clocktop/batty_trees_test_pcb/README.md

# batty_trees_test_pcb
KiCAD project for testing the Batty Trees TSMC June 2020 Tapeout
