clocktop/batty_trees_test_pcb/batty_trees_test_pcb/batty_trees_test_pcb_bom_dk_upload.csv

Qty | Digi-Key_PN
2 | EEE-FK1K470P
20 | 490-14466-1-ND
8 | 399-9247-1-ND
40 | 399-8000-1-ND
16 | B240A-FDICT-ND
6 | 1N4148W-FDICT-ND
4 | 455-1705-ND
4 | 455-1705-ND
8 | 952-2122-ND
2 | 2223-UJC-HP-3-SMT-CT-ND
2 | J576-ND
2 | J577-ND
2 | 609-3364-ND
2
12
24 | 311-10.0KCRCT
18 | 311-100KCRCT-ND
16 | P33KDACT-ND
8
18 | 311-1.00KCRCT-ND
4 | A129743CT-ND
6
8 | 311-10.0KCRCT-ND
4 | A126379CT-ND
6 | 3266W-203LF-ND
2 | 3266W-102LF-ND
2 | CW181-ND
24 | 296-41441-1-ND
6 | LT3042EMSE#TRPBFCT-ND
2 | AD8031ARTZ-REEL7CT-ND
2 | LTC1844ES5-SD#TRMPBFCT-ND
2
