clocktop/batty_trees_test_pcb/batty_trees_test_pcb/batty_trees_test_pcb.kicad_pcb

## KiCad design batty_trees_test_pcb/batty_trees_test_pcb.kicad_pcb (2020-09-01)

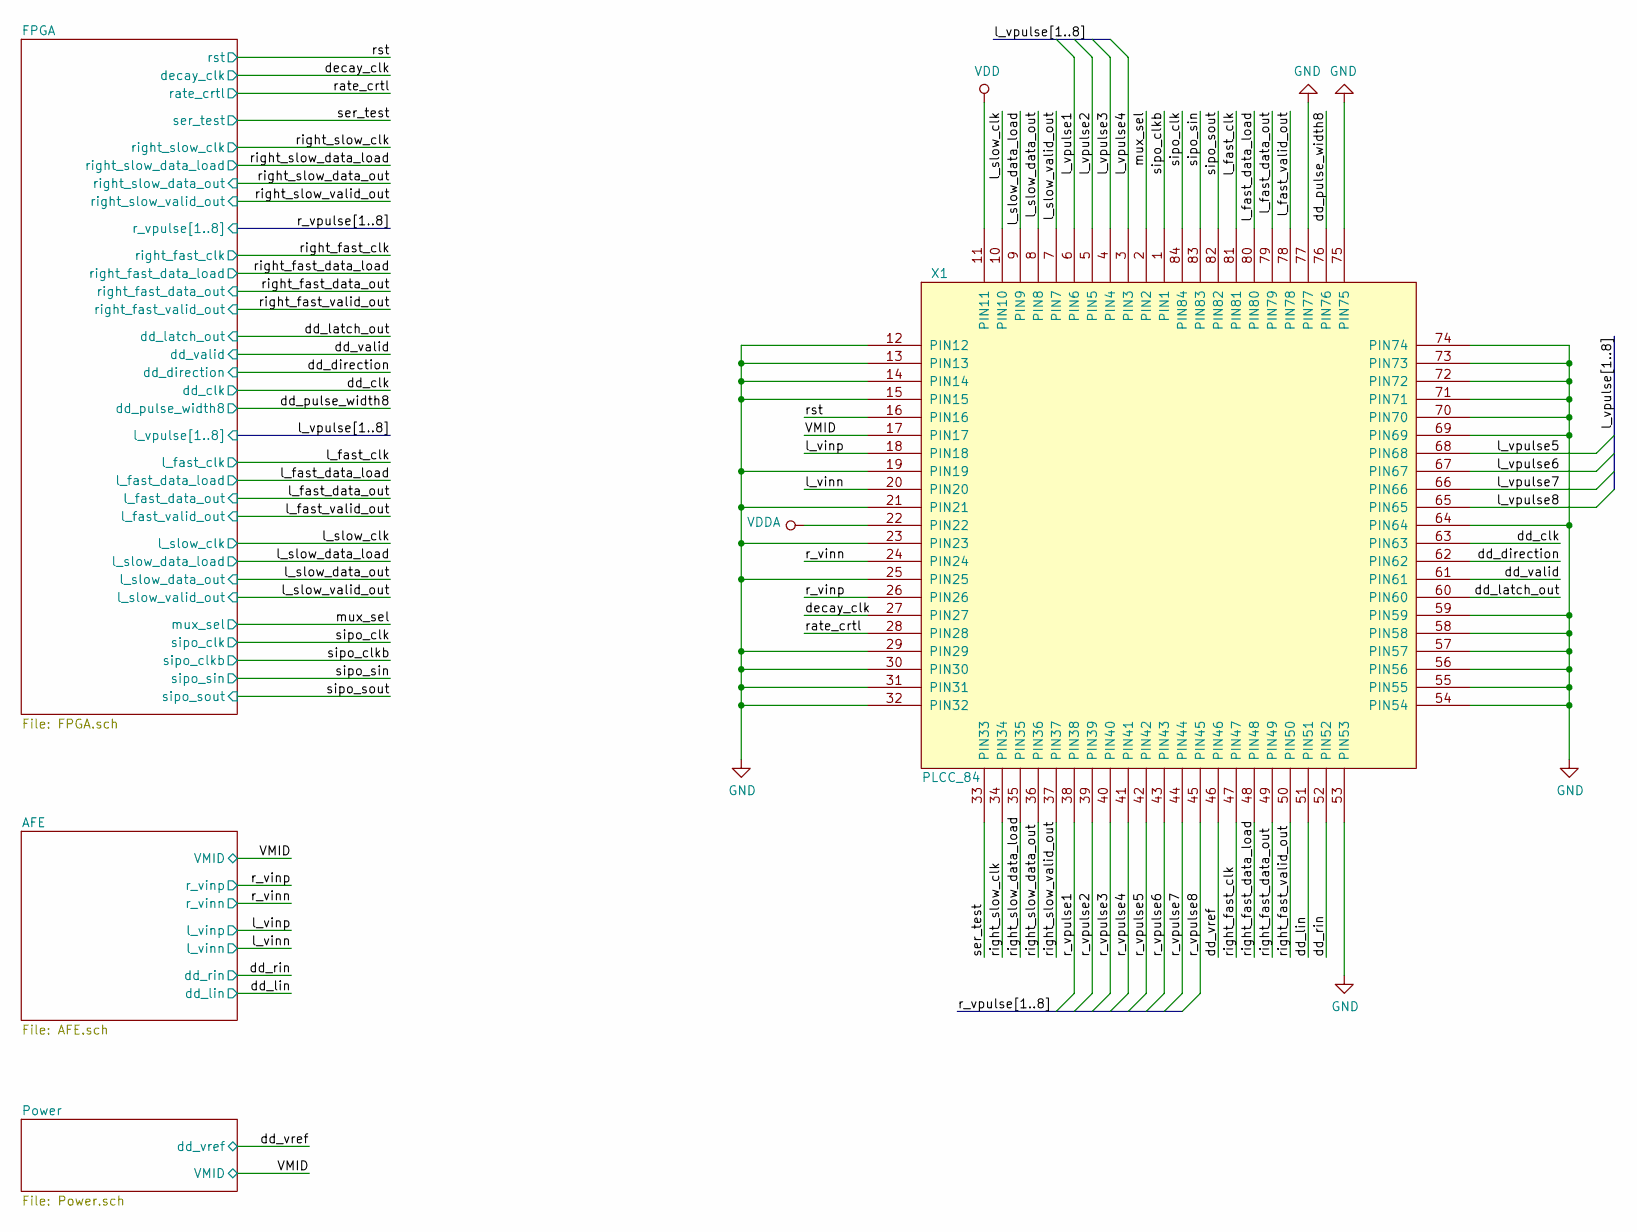
[picture p1: schematic batty_trees_test_pcb.sch, Batty Trees Test - Top]

Parts:
X1: PLCC_84; PLCC_84POS

Connections:
/VMID: X1.17 (PIN17); also elsewhere on the board
/dd_clk: X1.63 (PIN63); also elsewhere on the board
/dd_direction: X1.62 (PIN62); also elsewhere on the board
/dd_latch_out: X1.60 (PIN60); also elsewhere on the board
/dd_lin: X1.51 (PIN51); also elsewhere on the board
/dd_pulse_width8: X1.76 (PIN76); also elsewhere on the board
/dd_rin: X1.52 (PIN52); also elsewhere on the board
/dd_valid: X1.61 (PIN61); also elsewhere on the board
/dd_vref: X1.46 (PIN46); also elsewhere on the board
/decay_clk: X1.27 (PIN27); also elsewhere on the board
/l_fast_clk: X1.81 (PIN81); also elsewhere on the board
/l_fast_data_load: X1.80 (PIN80); also elsewhere on the board
/l_fast_data_out: X1.79 (PIN79); also elsewhere on the board
/l_fast_valid_out: X1.78 (PIN78); also elsewhere on the board
/l_slow_clk: X1.10 (PIN10); also elsewhere on the board
/l_slow_data_load: X1.9 (PIN9); also elsewhere on the board
/l_slow_data_out: X1.8 (PIN8); also elsewhere on the board
/l_slow_valid_out: X1.7 (PIN7); also elsewhere on the board
/l_vinn: X1.20 (PIN20); also elsewhere on the board
/l_vinp: X1.18 (PIN18); also elsewhere on the board
/l_vpulse1: X1.6 (PIN6); also elsewhere on the board
/l_vpulse2: X1.5 (PIN5); also elsewhere on the board
/l_vpulse3: X1.4 (PIN4); also elsewhere on the board
/l_vpulse4: X1.3 (PIN3); also elsewhere on the board
/l_vpulse5: X1.68 (PIN68); also elsewhere on the board
/l_vpulse6: X1.67 (PIN67); also elsewhere on the board
/l_vpulse7: X1.66 (PIN66); also elsewhere on the board
/l_vpulse8: X1.65 (PIN65); also elsewhere on the board
/mux_sel: X1.2 (PIN2); also elsewhere on the board
/r_vinn: X1.24 (PIN24); also elsewhere on the board
/r_vinp: X1.26 (PIN26); also elsewhere on the board
/r_vpulse1: X1.38 (PIN38); also elsewhere on the board
/r_vpulse2: X1.39 (PIN39); also elsewhere on the board
/r_vpulse3: X1.40 (PIN40); also elsewhere on the board
/r_vpulse4: X1.41 (PIN41); also elsewhere on the board
/r_vpulse5: X1.42 (PIN42); also elsewhere on the board
/r_vpulse6: X1.43 (PIN43); also elsewhere on the board
/r_vpulse7: X1.44 (PIN44); also elsewhere on the board
/r_vpulse8: X1.45 (PIN45); also elsewhere on the board
/rate_crtl: X1.28 (PIN28); also elsewhere on the board
/right_fast_clk: X1.47 (PIN47); also elsewhere on the board
/right_fast_data_load: X1.48 (PIN48); also elsewhere on the board
/right_fast_data_out: X1.49 (PIN49); also elsewhere on the board
/right_fast_valid_out: X1.50 (PIN50); also elsewhere on the board
/right_slow_clk: X1.34 (PIN34); also elsewhere on the board
/right_slow_data_load: X1.35 (PIN35); also elsewhere on the board
/right_slow_data_out: X1.36 (PIN36); also elsewhere on the board
/right_slow_valid_out: X1.37 (PIN37); also elsewhere on the board
/rst: X1.16 (PIN16); also elsewhere on the board
/ser_test: X1.33 (PIN33); also elsewhere on the board
/sipo_clk: X1.84 (PIN84); also elsewhere on the board
/sipo_clkb: X1.1 (PIN1); also elsewhere on the board
/sipo_sin: X1.83 (PIN83); also elsewhere on the board
/sipo_sout: X1.82 (PIN82); also elsewhere on the board
GND: X1.12 (PIN12), X1.13 (PIN13), X1.14 (PIN14), X1.15 (PIN15), X1.19 (PIN19), X1.21 (PIN21), X1.23 (PIN23), X1.25 (PIN25), X1.29 (PIN29), X1.30 (PIN30), X1.31 (PIN31), X1.32 (PIN32), X1.53 (PIN53), X1.54 (PIN54), X1.55 (PIN55), X1.56 (PIN56), X1.57 (PIN57), X1.58 (PIN58), X1.59 (PIN59), X1.64 (PIN64), X1.69 (PIN69), X1.70 (PIN70), X1.71 (PIN71), X1.72 (PIN72), X1.73 (PIN73), X1.74 (PIN74), X1.75 (PIN75), X1.77 (PIN77); also elsewhere on the board
VDD: X1.11 (PIN11); also elsewhere on the board
VDDA: X1.22 (PIN22); also elsewhere on the board

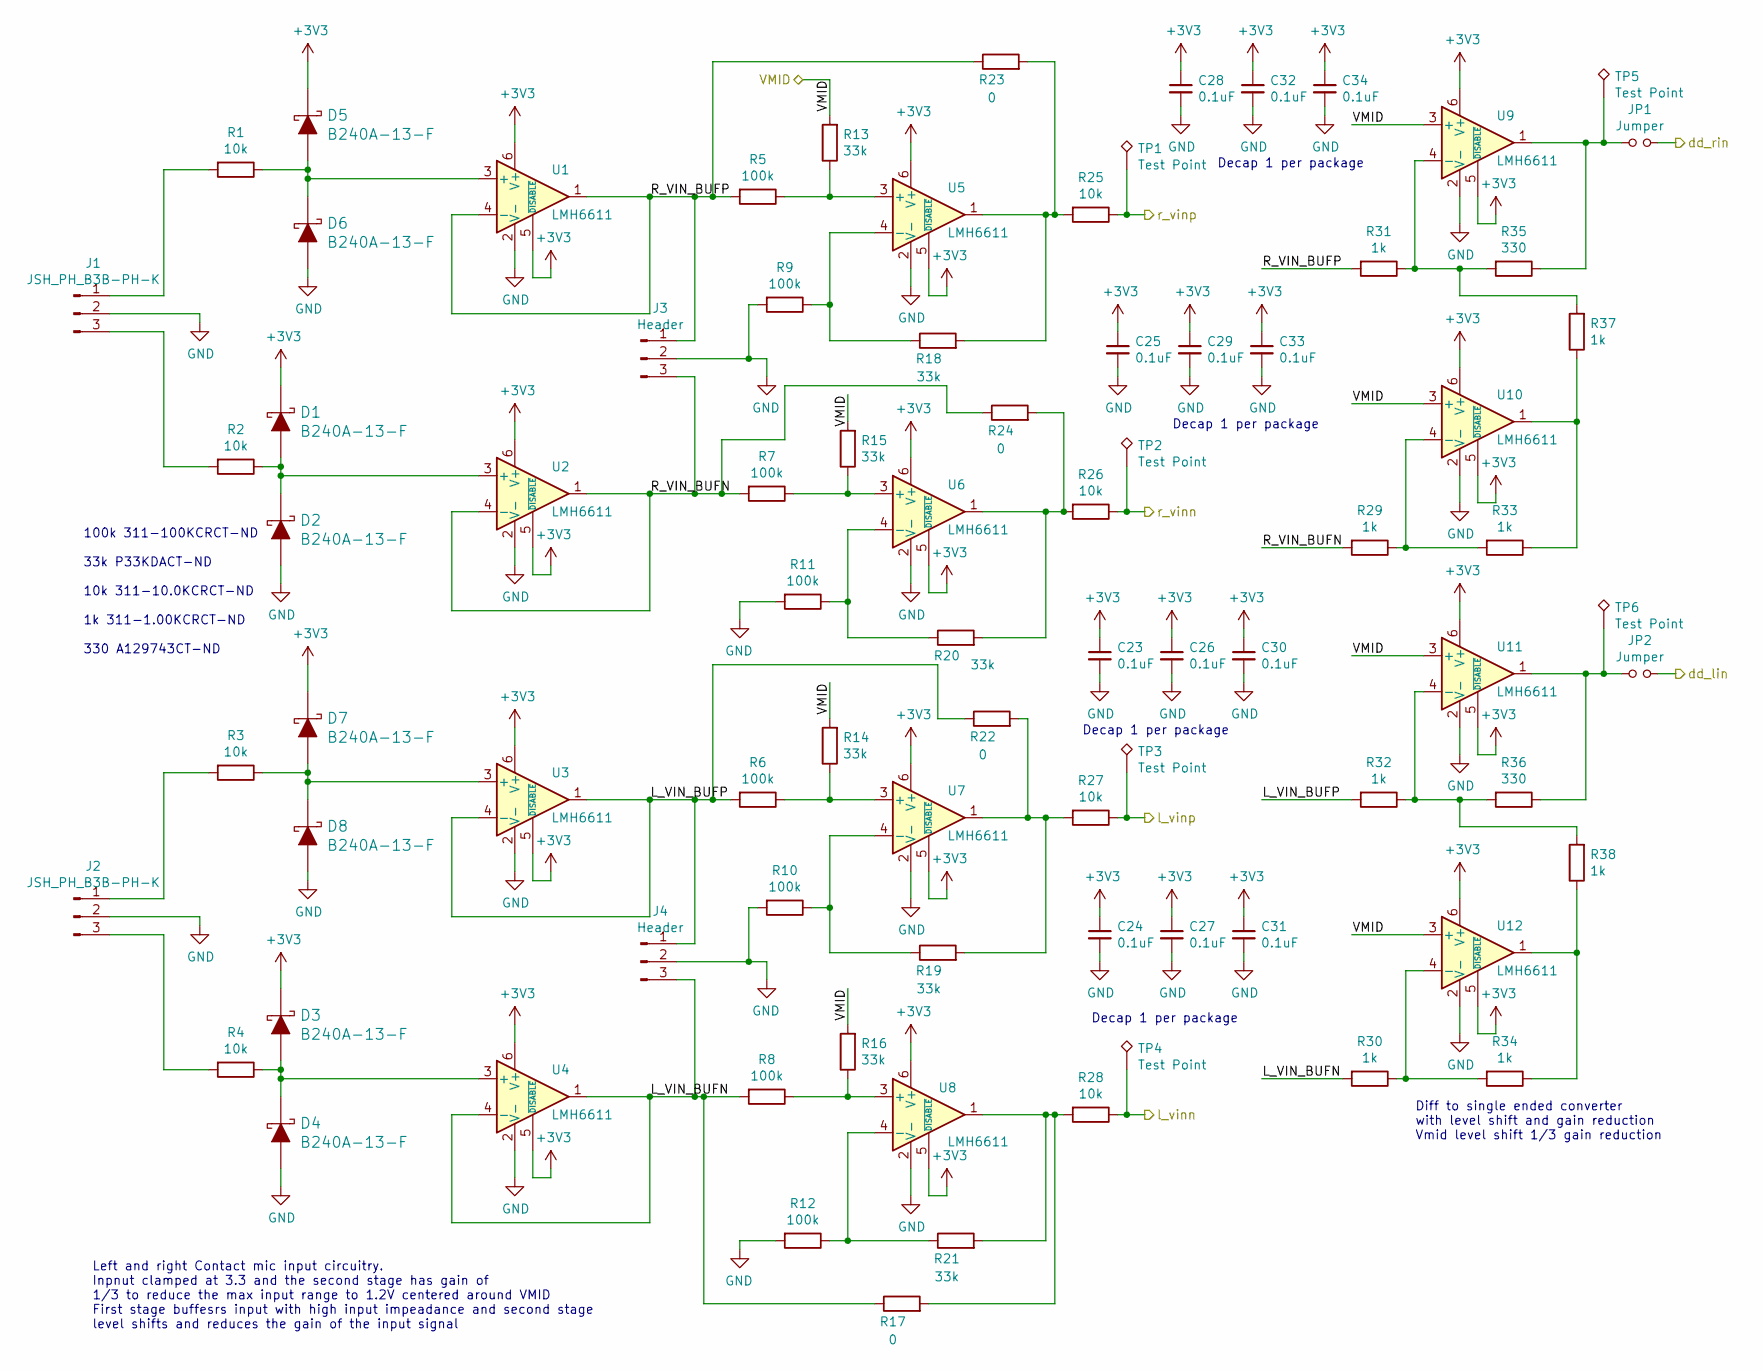
[picture p2: schematic AFE.sch]

Parts:
C23, C24, C25, C26, C27, C28, C29, C30, C31, C32, C33, C34: 0.1uF; C_0805_2012Metric_Pad1.15x1.40mm_HandSolder; Digi-Key_PN 399-8000-1-ND
D1, D2, D3, D4, D5, D6, D7, D8: B240A-13-F; DO-214AC; MPN B240A-13-F; Digi-Key_PN B240A-FDICT-ND
J1, J2: JSH_PH_B3B-PH-K; JST_PH_B3B-PH-K_1x03_P2.00mm_Vertical; Digi-Key_PN 455-1705-ND
J3, J4: Header; PinHeader_1x03_P2.54mm_Vertical; Digi-Key_PN 455-1705-ND
JP1, JP2: Jumper; PinHeader_1x02_P2.54mm_Vertical
R1, R2, R3, R4, R25, R26, R27, R28: 10k; R_0805_2012Metric_Pad1.15x1.40mm_HandSolder; Digi-Key_PN 311-10.0KCRCT
R5, R6, R7, R8, R9, R10, R11, R12: 100k; R_0805_2012Metric_Pad1.15x1.40mm_HandSolder; Digi-Key_PN 311-100KCRCT-ND
R13, R14, R15, R16, R18, R19, R20, R21: 33k; R_0805_2012Metric_Pad1.15x1.40mm_HandSolder; Digi-Key_PN P33KDACT-ND
R17, R22, R23, R24: 0; R_0805_2012Metric_Pad1.15x1.40mm_HandSolder
R29, R30, R31, R32, R33, R34, R37, R38: 1k; R_0805_2012Metric_Pad1.15x1.40mm_HandSolder; Digi-Key_PN 311-1.00KCRCT-ND
R35, R36: 330; R_0805_2012Metric_Pad1.15x1.40mm_HandSolder; Digi-Key_PN A129743CT-ND
TP1, TP2, TP3, TP4, TP5, TP6: Test Point; Keystone_5019; Digi-Key_PN 36-5019CT-ND
U1, U2, U3, U4, U5, U6, U7, U8, U9, U10, U11, U12: LMH6611; TSOT-23-6; Digi-Key_PN 296-41441-1-ND

Connections:
+3V3: C23.1, C24.1, C25.1, C26.1, C27.1, C28.1, C29.1, C30.1, C31.1, C32.1, C33.1, C34.1, D1.K, D3.K, D5.K, D7.K, U1.5 (~DISABLE), U1.6 (V+), U2.5 (~DISABLE), U2.6 (V+), U3.5 (~DISABLE), U3.6 (V+), U4.5 (~DISABLE), U4.6 (V+), U5.5 (~DISABLE), U5.6 (V+), U6.5 (~DISABLE), U6.6 (V+), U7.5 (~DISABLE), U7.6 (V+), U8.5 (~DISABLE), U8.6 (V+), U9.5 (~DISABLE), U9.6 (V+), U10.5 (~DISABLE), U10.6 (V+), U11.5 (~DISABLE), U11.6 (V+), U12.5 (~DISABLE), U12.6 (V+); also elsewhere on the board
/AFE/L_VIN_BUFN: J4.3, R8.2, R17.1, R30.2, U4.1, U4.4 (-)
/AFE/L_VIN_BUFP: J4.1, R6.2, R22.1, R32.2, U3.1, U3.4 (-)
/AFE/R_VIN_BUFN: J3.3, R7.2, R24.1, R29.2, U2.1, U2.4 (-)
/AFE/R_VIN_BUFP: J3.1, R5.2, R23.1, R31.2, U1.1, U1.4 (-)
/VMID: R13.2, R14.2, R15.2, R16.2, U9.3 (+), U10.3 (+), U11.3 (+), U12.3 (+); also elsewhere on the board
/dd_lin: JP2.2; also elsewhere on the board
/dd_rin: JP1.2; also elsewhere on the board
/l_vinn: R28.1, TP4.1; also elsewhere on the board
/l_vinp: R27.1, TP3.1; also elsewhere on the board
/r_vinn: R26.1, TP2.1; also elsewhere on the board
/r_vinp: R25.1, TP1.1; also elsewhere on the board
GND: C23.2, C24.2, C25.2, C26.2, C27.2, C28.2, C29.2, C30.2, C31.2, C32.2, C33.2, C34.2, D2.A, D4.A, D6.A, D8.A, J1.2, J2.2, J3.2, J4.2, R9.2, R10.2, R11.2, R12.2, U1.2 (V-), U2.2 (V-), U3.2 (V-), U4.2 (V-), U5.2 (V-), U6.2 (V-), U7.2 (V-), U8.2 (V-), U9.2 (V-), U10.2 (V-), U11.2 (V-), U12.2 (V-); also elsewhere on the board
unnamed: D1.A, D2.K, R2.1, U2.3 (+)
unnamed: D3.A, D4.K, R4.1, U4.3 (+)
unnamed: D5.A, D6.K, R1.1, U1.3 (+)
unnamed: D7.A, D8.K, R3.1, U3.3 (+)
unnamed: J1.1, R1.2
unnamed: J1.3, R2.2
unnamed: J2.1, R3.2
unnamed: J2.3, R4.2
unnamed: JP1.1, R35.1, TP5.1, U9.1
unnamed: JP2.1, R36.1, TP6.1, U11.1
unnamed: R10.1, R19.1, U7.4 (-)
unnamed: R11.1, R20.1, U6.4 (-)
unnamed: R12.1, R21.1, U8.4 (-)
unnamed: R5.1, R13.1, U5.3 (+)
unnamed: R6.1, R14.1, U7.3 (+)
unnamed: R7.1, R15.1, U6.3 (+)
unnamed: R8.1, R16.1, U8.3 (+)
unnamed: R17.2, R21.2, R28.2, U8.1
unnamed: R9.1, R18.1, U5.4 (-)
unnamed: R18.2, R23.2, R25.2, U5.1
unnamed: R19.2, R22.2, R27.2, U7.1
unnamed: R20.2, R24.2, R26.2, U6.1
unnamed: R29.1, R33.2, U10.4 (-)
unnamed: R30.1, R34.2, U12.4 (-)
unnamed: R31.1, R35.2, R37.2, U9.4 (-)
unnamed: R32.1, R36.2, R38.2, U11.4 (-)
unnamed: R33.1, R37.1, U10.1
unnamed: R34.1, R38.1, U12.1

Notes on the sheet:
Left and right Contact mic input circuitry. Inpnut clamped at 3.3 and the second stage has gain of 1/3 to reduce the max input range to 1.2V centered around VMID First stage buffesrs input with high input impeadance and second stage level shifts and reduces the gain of the input signal
Diff to single ended converter with level shift and gain reduction Vmid level shift 1/3 gain reduction
Decap 1 per package
100k 311-100KCRCT-ND 33k P33KDACT-ND 10k 311-10.0KCRCT-ND 1k 311-1.00KCRCT-ND 330 A129743CT-ND

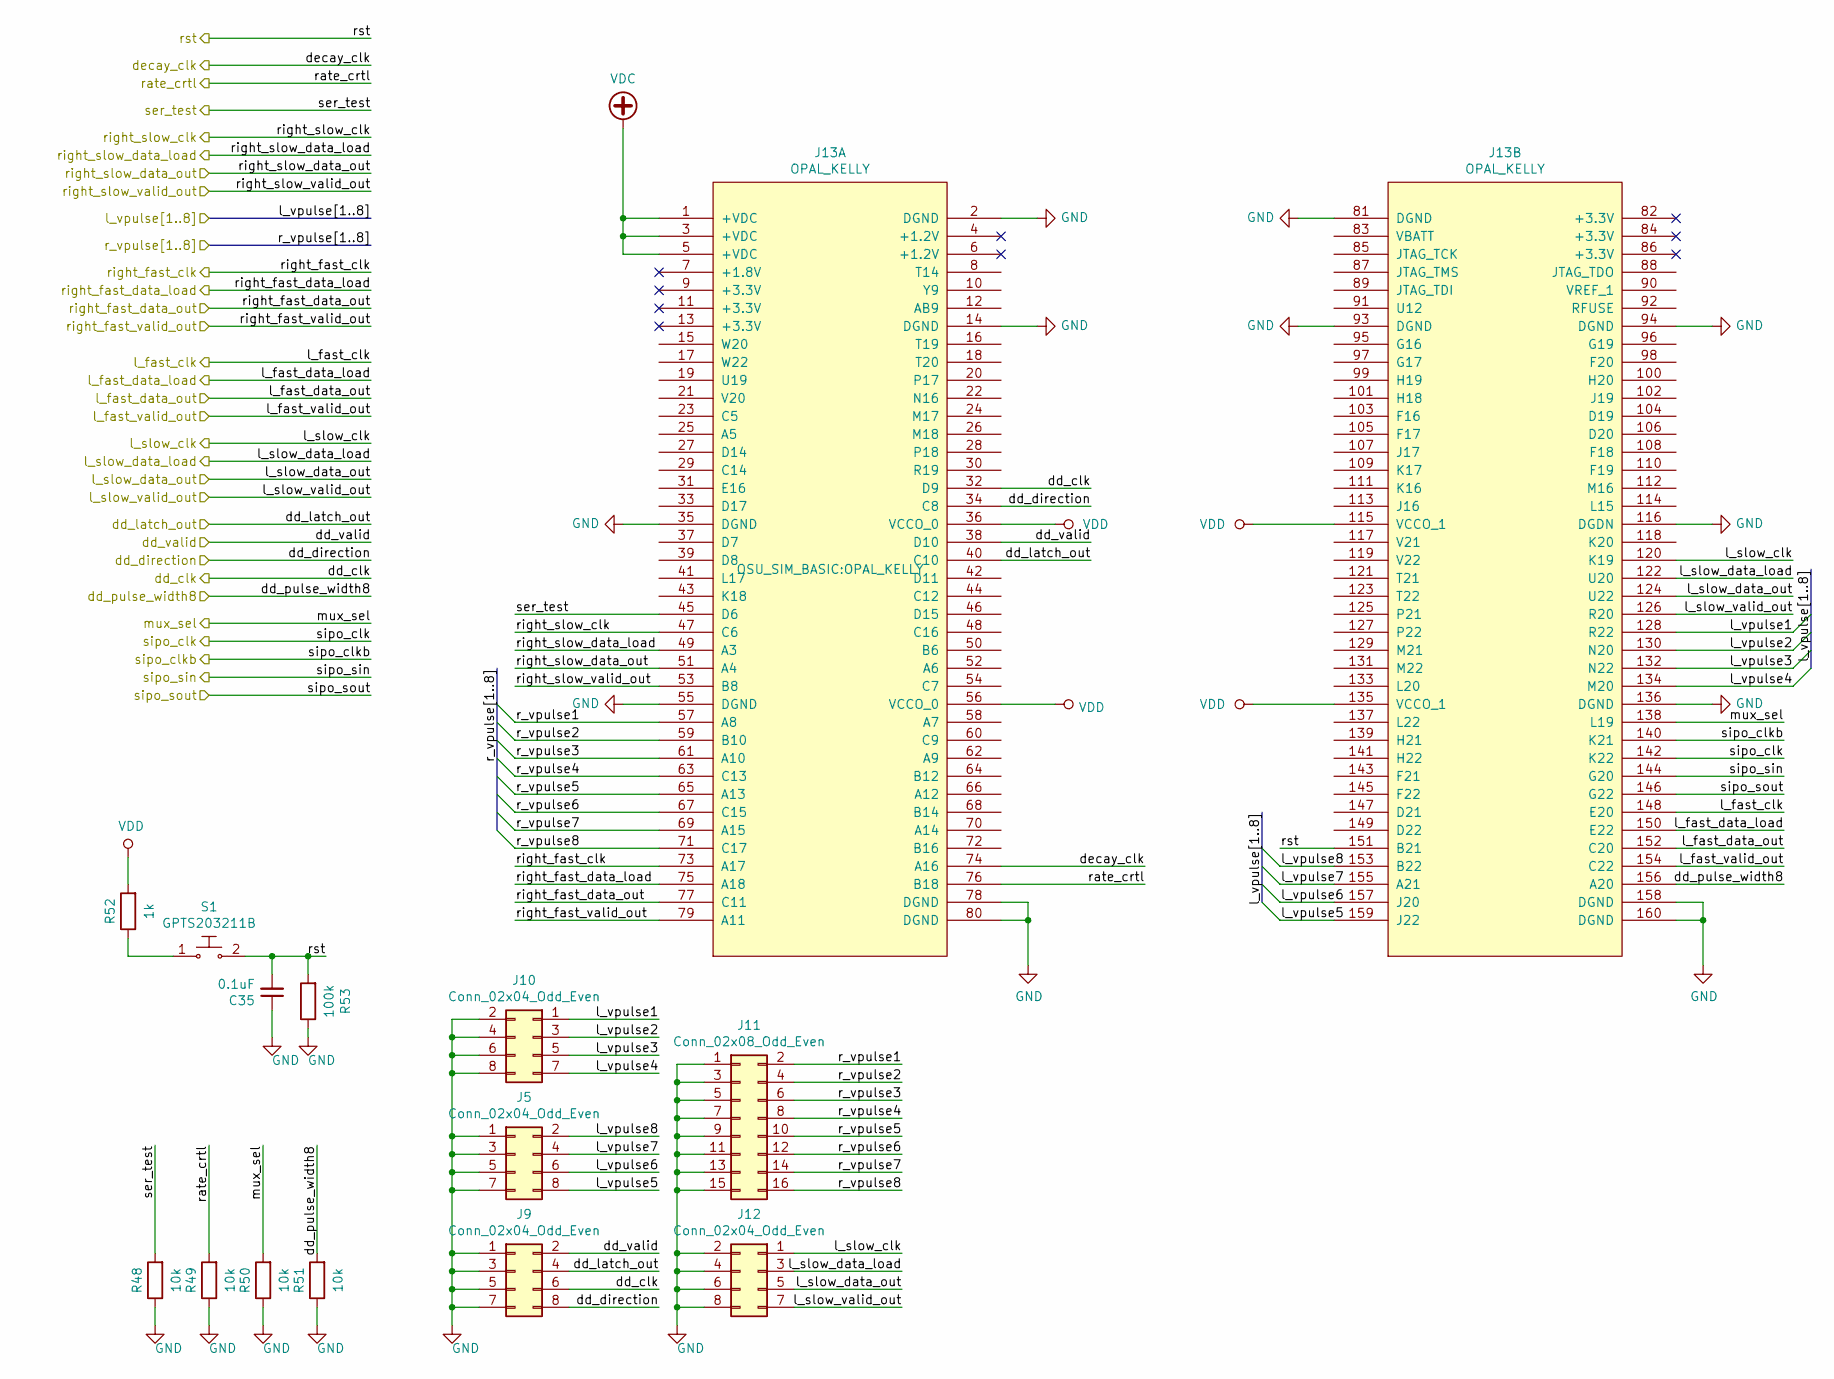
[picture p3: schematic FPGA.sch, Batty Trees - FPGA]

Parts:
C35: 0.1uF; C_0805_2012Metric_Pad1.15x1.40mm_HandSolder; Digi-Key_PN 399-8000-1-ND
J5, J9, J10, J12: Conn_02x04_Odd_Even; PinHeader_2x04_P2.54mm_Vertical; Digi-Key_PN 952-2122-ND
J11: Conn_02x08_Odd_Even; PinHeader_2x08_P2.54mm_Vertical; Digi-Key_PN 609-3364-ND
J13: OPAL_KELLY
R48, R49, R51: 10k; R_0805_2012Metric_Pad1.15x1.40mm_HandSolder; Digi-Key_PN 311-10.0KCRCT-ND
R50: 10k; R_0805_2012Metric_Pad1.15x1.40mm_HandSolder; Digi-Key-PN 311-10.0KCRCT-ND
R52: 1k; R_0805_2012Metric_Pad1.15x1.40mm_HandSolder; Digi-Key-PN 311-1.00KCRCT-ND
R53: 100k; R_0805_2012Metric_Pad1.15x1.40mm_HandSolder; Digi-Key_PN 311-100KCRCT-ND
S1: GPTS203211B; PushButton_12x12mm_THT_GPTS203211B; MPN GPTS203211B; Digi-Key_PN CW181-ND

Connections:
/dd_clk: J9.6, J13.32 (D9); also elsewhere on the board
/dd_direction: J9.8, J13.34 (C8); also elsewhere on the board
/dd_latch_out: J9.4, J13.40 (C10); also elsewhere on the board
/dd_pulse_width8: J13.156 (A20), R51.2; also elsewhere on the board
/dd_valid: J9.2, J13.38 (D10); also elsewhere on the board
/decay_clk: J13.74 (A16); also elsewhere on the board
/l_fast_clk: J13.148 (E20); also elsewhere on the board
/l_fast_data_load: J13.150 (E22); also elsewhere on the board
/l_fast_data_out: J13.152 (C20); also elsewhere on the board
/l_fast_valid_out: J13.154 (C22); also elsewhere on the board
/l_slow_clk: J12.1, J13.120 (K19); also elsewhere on the board
/l_slow_data_load: J12.3, J13.122 (U20); also elsewhere on the board
/l_slow_data_out: J12.5, J13.124 (U22); also elsewhere on the board
/l_slow_valid_out: J12.7, J13.126 (R20); also elsewhere on the board
/l_vpulse1: J10.1, J13.128 (R22); also elsewhere on the board
/l_vpulse2: J10.3, J13.130 (N20); also elsewhere on the board
/l_vpulse3: J10.5, J13.132 (N22); also elsewhere on the board
/l_vpulse4: J10.7, J13.134 (M20); also elsewhere on the board
/l_vpulse5: J5.8, J13.159 (J22); also elsewhere on the board
/l_vpulse6: J5.6, J13.157 (J20); also elsewhere on the board
/l_vpulse7: J5.4, J13.155 (A21); also elsewhere on the board
/l_vpulse8: J5.2, J13.153 (B22); also elsewhere on the board
/mux_sel: J13.138 (L19), R50.2; also elsewhere on the board
/r_vpulse1: J11.2, J13.57 (A8); also elsewhere on the board
/r_vpulse2: J11.4, J13.59 (B10); also elsewhere on the board
/r_vpulse3: J11.6, J13.61 (A10); also elsewhere on the board
/r_vpulse4: J11.8, J13.63 (C13); also elsewhere on the board
/r_vpulse5: J11.10, J13.65 (A13); also elsewhere on the board
/r_vpulse6: J11.12, J13.67 (C15); also elsewhere on the board
/r_vpulse7: J11.14, J13.69 (A15); also elsewhere on the board
/r_vpulse8: J11.16, J13.71 (C17); also elsewhere on the board
/rate_crtl: J13.76 (B18), R49.2; also elsewhere on the board
/right_fast_clk: J13.73 (A17); also elsewhere on the board
/right_fast_data_load: J13.75 (A18); also elsewhere on the board
/right_fast_data_out: J13.77 (C11); also elsewhere on the board
/right_fast_valid_out: J13.79 (A11); also elsewhere on the board
/right_slow_clk: J13.47 (C6); also elsewhere on the board
/right_slow_data_load: J13.49 (A3); also elsewhere on the board
/right_slow_data_out: J13.51 (A4); also elsewhere on the board
/right_slow_valid_out: J13.53 (B8); also elsewhere on the board
/rst: C35.2, J13.151 (B21), R53.2, S1.2; also elsewhere on the board
/ser_test: J13.45 (D6), R48.2; also elsewhere on the board
/sipo_clk: J13.142 (K22); also elsewhere on the board
/sipo_clkb: J13.140 (K21); also elsewhere on the board
/sipo_sin: J13.144 (G20); also elsewhere on the board
/sipo_sout: J13.146 (G22); also elsewhere on the board
GND: C35.1, J5.1, J5.3, J5.5, J5.7, J9.1, J9.3, J9.5, J9.7, J10.2, J10.4, J10.6, J10.8, J11.1, J11.3, J11.5, J11.7, J11.9, J11.11, J11.13, J11.15, J12.2, J12.4, J12.6, J12.8, J13.2 (DGND), J13.14 (DGND), J13.35 (DGND), J13.55 (DGND), J13.78 (DGND), J13.80 (DGND), J13.81 (DGND), J13.93 (DGND), J13.94 (DGND), J13.116 (DGDN), J13.136 (DGND), J13.158 (DGND), J13.160 (DGND), R48.1, R49.1, R50.1, R51.1, R53.1; also elsewhere on the board
unnamed: R52.1, S1.1
VDC: J13.1 (+VDC), J13.3 (+VDC), J13.5 (+VDC); also elsewhere on the board
VDD: J13.36 (VCCO_0), J13.56 (VCCO_0), J13.115 (VCCO_1), J13.135 (VCCO_1), R52.2; also elsewhere on the board

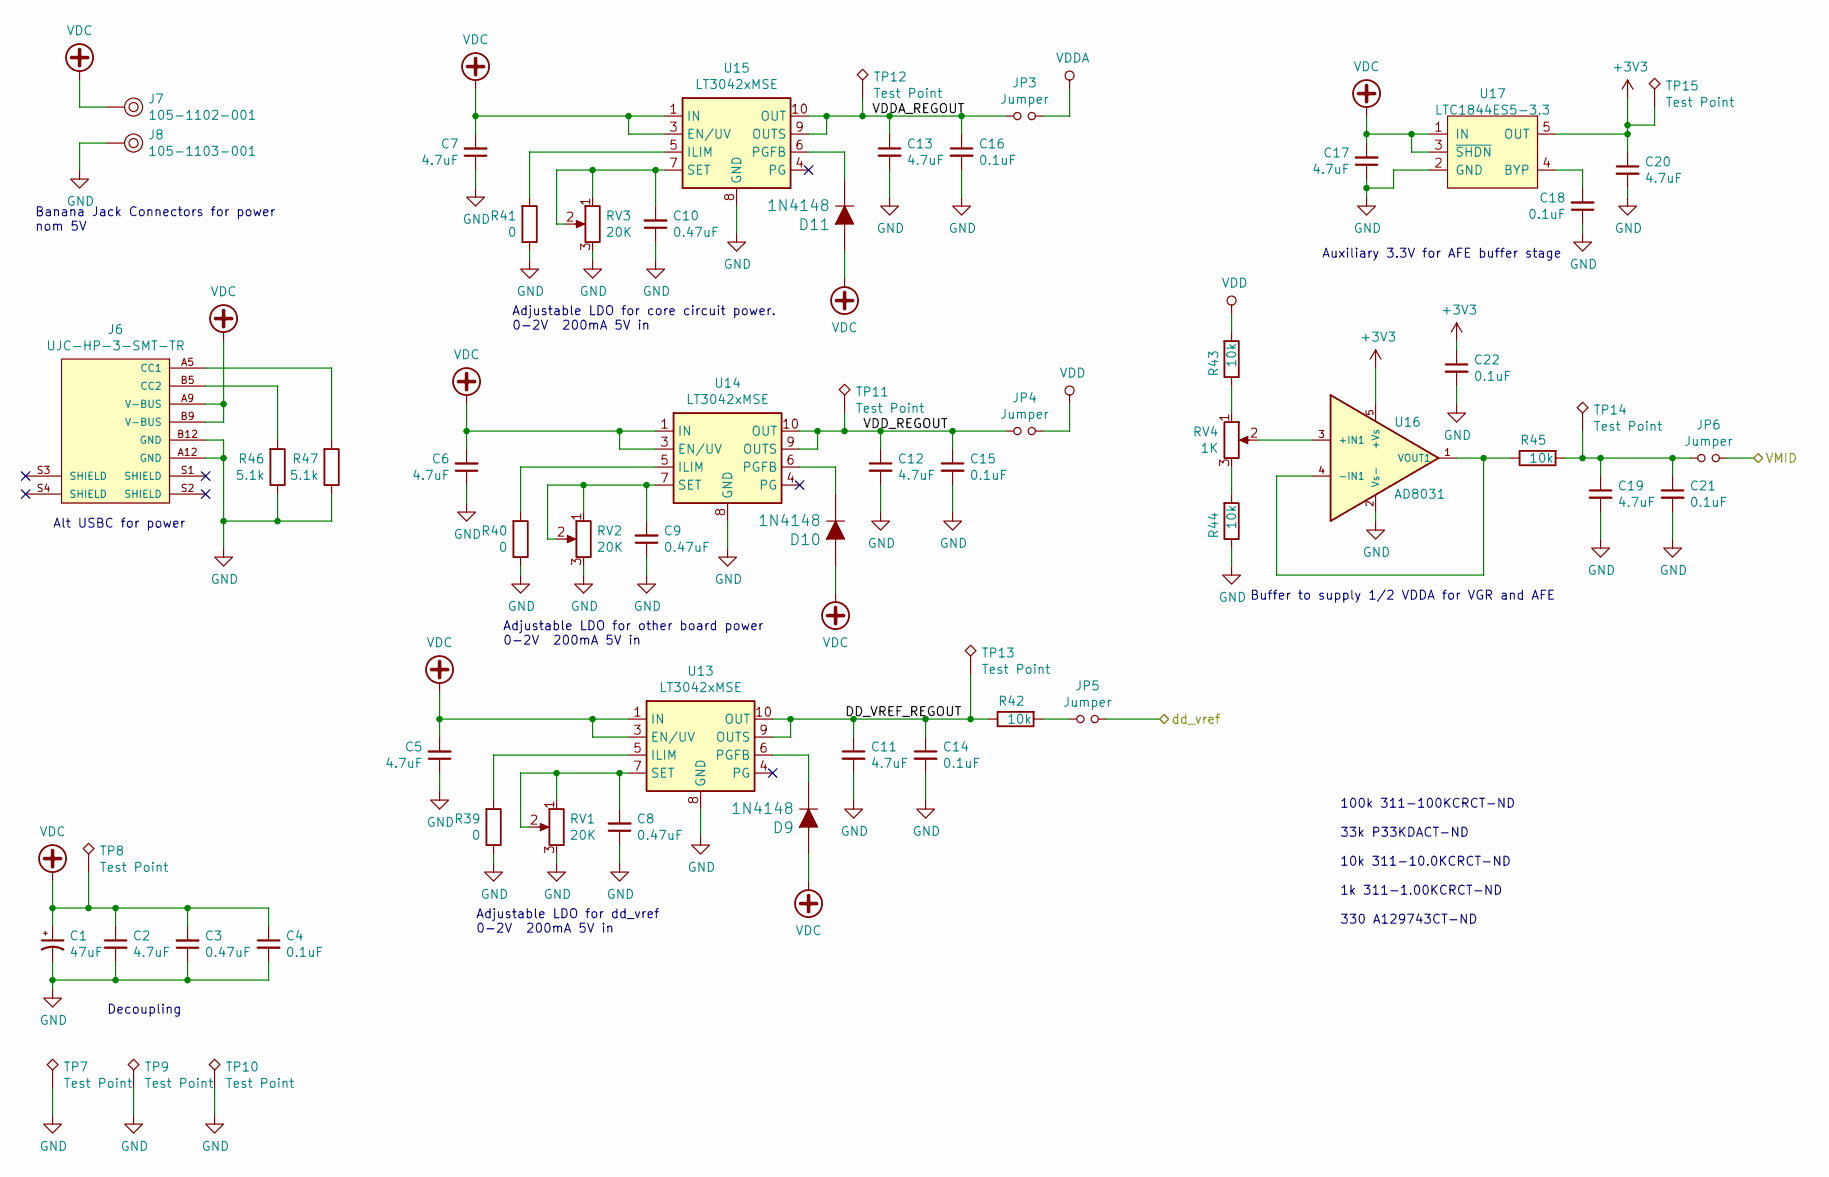
[picture p4: schematic Power.sch, Batty Trees - Power and References]

Parts:
C1: 47uF; CP_Elec_10x10; Digi-Key_PN EEE-FK1K470P
C2, C5, C6, C7, C11, C12, C13, C17, C19, C20: 4.7uF; C_0805_2012Metric_Pad1.15x1.40mm_HandSolder; Digi-Key_PN 490-14466-1-ND
C3, C8, C9, C10: 0.47uF; C_0805_2012Metric_Pad1.15x1.40mm_HandSolder; Digi-Key_PN 399-9247-1-ND
C4, C14, C15, C16, C18, C21, C22: 0.1uF; C_0805_2012Metric_Pad1.15x1.40mm_HandSolder; Digi-Key_PN 399-8000-1-ND
D9, D10, D11: 1N4148; SOD-123; MPN 1N4148W-7-F; Digi-Key_PN 1N4148W-FDICT-ND
J6: UJC-HP-3-SMT-TR; CUI_UJC-HP-3-SMT-TR; Digi-Key_PN 2223-UJC-HP-3-SMT-CT-ND
J7: 105-1102-001; Test_Jack_Horiz; MPN 105-1102-001; Digi-Key_PN J576-ND
J8: 105-1103-001; Test_Jack_Horiz; MPN 105-1103-001; Digi-Key_PN J577-ND
JP3, JP4, JP5, JP6: Jumper; PinHeader_1x02_P2.54mm_Vertical
R39, R40, R41: 0; C_0805_2012Metric_Pad1.15x1.40mm_HandSolder
R42, R43, R44, R45: 10k; C_0805_2012Metric_Pad1.15x1.40mm_HandSolder; Digi-Key_PN 311-10.0KCRCT-ND
R46, R47: 5.1k; C_0805_2012Metric_Pad1.15x1.40mm_HandSolder; Digi-Key_PN A126379CT-ND
RV1, RV2, RV3: 20K; Potentiometer_Bourns_3266W_Vertical; Digi-Key_PN 3266W-203LF-ND
RV4: 1K; Potentiometer_Bourns_3266W_Vertical; Digi-Key_PN 3266W-102F-ND
TP7, TP8, TP9, TP10, TP11, TP12, TP13, TP14, TP15: Test Point; Keystone_5019; Digi-Key_PN 36-5019CT-ND
U13, U14, U15: LT3042xMSE; MSOP-10-1EP_3x3mm_P0.5mm_EP1.68x1.88mm; Digi-Key_PN LT3042EMSE#TRPBFCT-ND
U16: AD8031; SOT-23-5; Digi-Key_PN AD8031ARTZ-REEL7CT-ND
U17: LTC1844ES5-3.3; SOT-23-5_HandSoldering; Digi-Key_PN LTC1844ES5-SD#TRMPBFCT-ND

Connections:
+3V3: C20.1, C22.1, TP15.1, U16.5 (+Vs), U17.5 (OUT); also elsewhere on the board
/Power/DD_VREF_REGOUT: C11.1, C14.1, R42.1, TP13.1, U13.9 (OUTS), U13.10 (OUT)
/Power/VDDA_REGOUT: C13.1, C16.1, JP3.1, TP12.1, U15.9 (OUTS), U15.10 (OUT)
/Power/VDD_REGOUT: C12.1, C15.1, JP4.1, TP11.1, U14.9 (OUTS), U14.10 (OUT)
/VMID: JP6.2; also elsewhere on the board
/dd_vref: JP5.2; also elsewhere on the board
GND: C1.2, C2.2, C3.1, C4.2, C5.1, C6.1, C7.1, C8.1, C9.1, C10.1, C11.2, C12.2, C13.2, C14.2, C15.2, C16.2, C17.1, C18.1, C19.2, C20.2, C21.2, C22.2, J6.A12 (GND), J6.B12 (GND), J8.1, R39.1, R40.1, R41.1, R44.1, R46.1, R47.1, RV1.3, RV2.3, RV3.3, TP7.1, TP9.1, TP10.1, U13.8 (GND), U13.11 (GND), U14.8 (GND), U14.11 (GND), U15.8 (GND), U15.11 (GND), U16.2 (Vs-), U17.2 (GND); also elsewhere on the board
unnamed: C8.2, RV1.1, RV1.2, U13.7 (SET)
unnamed: C9.2, RV2.1, RV2.2, U14.7 (SET)
unnamed: C10.2, RV3.1, RV3.2, U15.7 (SET)
unnamed: C18.2, U17.4 (BYP)
unnamed: C19.1, C21.1, JP6.1, R45.2, TP14.1
unnamed: D9.K, U13.6 (PGFB)
unnamed: D10.K, U14.6 (PGFB)
unnamed: D11.K, U15.6 (PGFB)
unnamed: J6.A5 (CC1), R47.2
unnamed: J6.B5 (CC2), R46.2
unnamed: JP5.1, R42.2
unnamed: R39.2, U13.5 (ILIM)
unnamed: R40.2, U14.5 (ILIM)
unnamed: R41.2, U15.5 (ILIM)
unnamed: R43.1, RV4.1
unnamed: R44.2, RV4.3
unnamed: R45.1, U16.1 (VOUT1), U16.4 (-IN1)
unnamed: RV4.2, U16.3 (+IN1)
VDC: C1.1, C2.1, C3.2, C4.1, C5.2, C6.2, C7.2, C17.2, D9.A, D10.A, D11.A, J6.A9 (V-BUS), J6.B9 (V-BUS), J7.1, TP8.1, U13.1 (IN), U13.2 (IN), U13.3 (EN/UV), U14.1 (IN), U14.2 (IN), U14.3 (EN/UV), U15.1 (IN), U15.2 (IN), U15.3 (EN/UV), U17.1 (IN), U17.3 (~SHDN); also elsewhere on the board
VDD: JP4.2, R43.2; also elsewhere on the board
VDDA: JP3.2; also elsewhere on the board

Notes on the sheet:
Banana Jack Connectors for power nom 5V
Adjustable LDO for core circuit power. 0-2V 200mA 5V in
Adjustable LDO for other board power 0-2V 200mA 5V in
Auxiliary 3.3V for AFE buffer stage
Decoupling
Adjustable LDO for dd_vref 0-2V 200mA 5V in
Buffer to supply 1/2 VDDA for VGR and AFE
Alt USBC for power
100k 311-100KCRCT-ND 33k P33KDACT-ND 10k 311-10.0KCRCT-ND 1k 311-1.00KCRCT-ND 330 A129743CT-ND

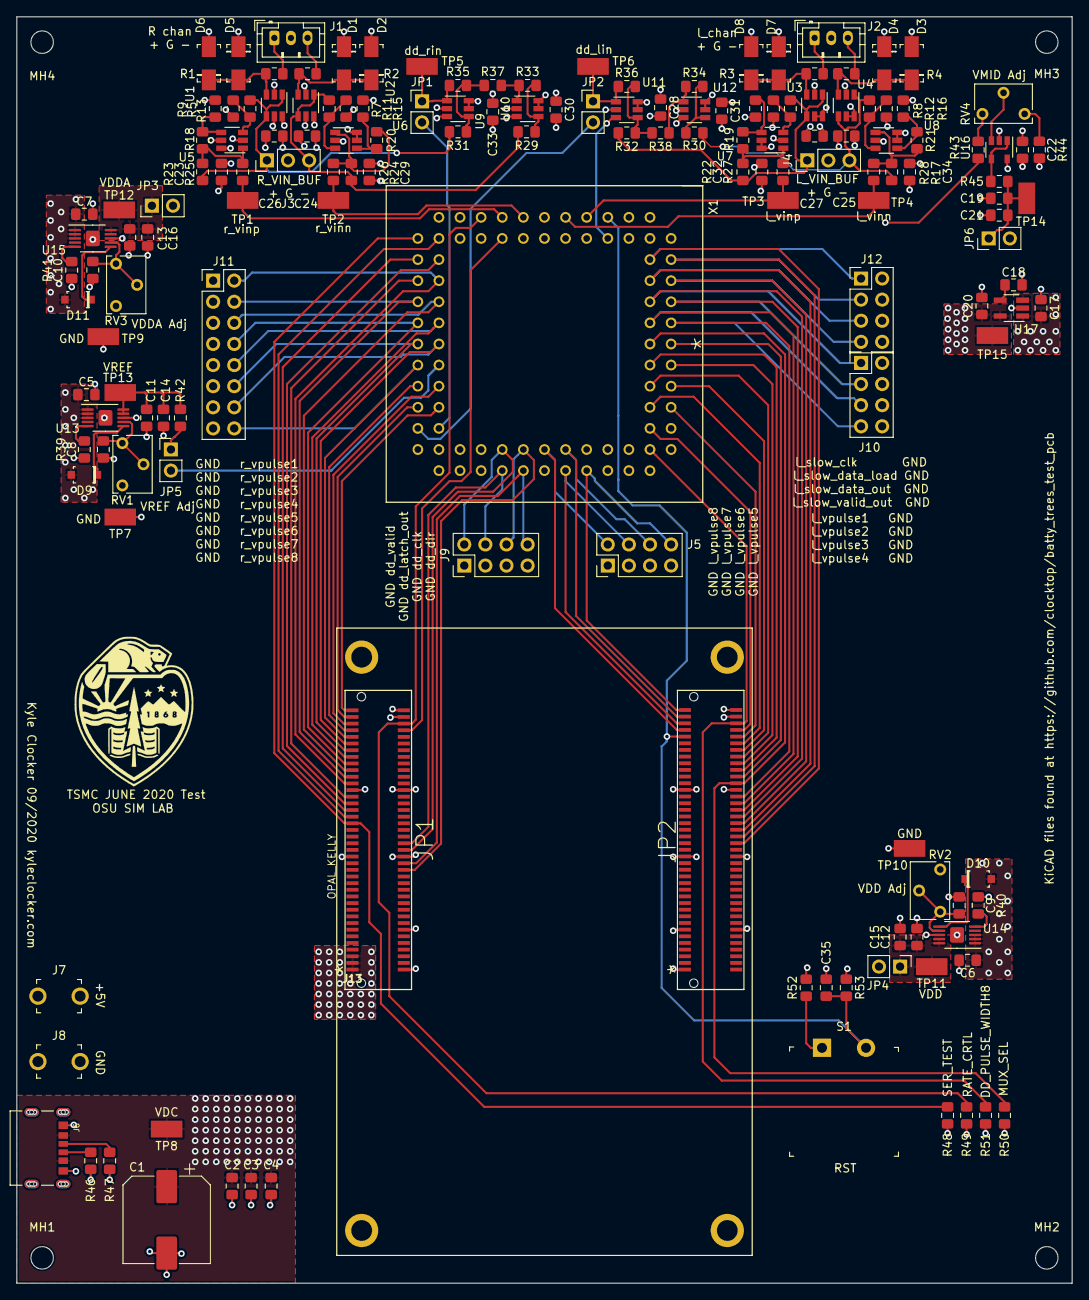
[picture p5: board batty_trees_test_pcb.kicad_pcb from above]

Board: 4 copper layers, 127.0 x 152.4 mm, 160 parts (0 on the bottom side), 113 nets.

Other parts of the board:
MH1, MH2, MH3, MH4: MountingHole_2.7mm_M2.5
