clocktop/batty_trees_test_pcb/(commit log)

2020-08-13 started kicad project
    [batty_trees_test_pcb.kicad_pcb, batty_trees_test_pcb.sch]
2020-08-18 power and references section 95% done
    [AFE.sch, FPGA.sch, Power.sch, Power_References.sch, batty_trees_test_pcb.sch]
2020-08-19 Finished off Power section and made up AFE schematic
    [AFE.sch, Power.sch, batty_trees_test_pcb.sch]
2020-08-26 wired up chip to fpga on schematic and begininng to do layout
    [AFE.sch, FPGA.sch, Power.sch, batty_trees_test_pcb.sch]
2020-08-29 more layout work ~90% finished
    [AFE.sch, FPGA.sch, Power.sch, batty_trees_test_pcb.kicad_pcb]
2020-09-01 Layout finished and gerbers generated checking for DFM
    [FPGA.sch, Power.sch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]
2020-09-01 all componenets updated with digikey pn bom generated
    [AFE.sch, FPGA.sch, Power.sch, batty_trees_test_pcb_bom.csv]
2020-09-01 final ordering revision
    [batty_trees_test_pcb-B_Cu.gbl, batty_trees_test_pcb-B_Mask.gbs, batty_trees_test_pcb-B_Paste.gbp, batty_trees_test_pcb-B_SilkS.gbo, batty_trees_test_pcb-Edge_Cuts.gm1, batty_trees_test_pcb-F_Cu.gtl, batty_trees_test_pcb-F_Mask.gts, batty_trees_test_pcb-F_Paste.gtp]
